tomekszafranski/Amiga500-SuperSelector/README.md

# Super Selector for Amiga 500

## Story

If you have real hardware Commodore Amiga 500 but don't have a wide collection of 3.5" floppies you probably would use Gotek drive for loading programs. But because most programs want to run from DF0, you need a device called _boot selector_ that allows changing drives assignment and boot from Gotek instead of internal drive. This is usually achieved using small switch mounted somewhere in the case or switchless by pressing Ctrl-Amiga-Amiga key combination for longer time. Great! Next, you may also want to have Kickstart ROM selector that allows having two or more versions of Kickstart e.g. Kickstart 3.1 (or later) for its features and older Kickstart 1.3 for compatibility. Again, this can be done by a switch mounted somewhere is the case or switchless by pressing Ctrl-Amiga-Amiga keys for longer time. The problem is when you want to use both devices and both switchless versions - they will probably mix up and there is no simple way to fix it as there is usially no possibility to reprogram/integrate them.

## How it works

This Super Selector allows to change two setting using one device. This is how it works:
* If you press Ctrl-Amiga-Amiga briefly or press and release it in less than 3 seconds, simple reset is executed. 
* If you keep Ctrl-Amiga-Amiga combination pressed beyond 3 seconds you will hear short tick - now you are in boot selector mode. If you release keys now, you will toggle boot device. After releasing keys you will hear one beep, meaning that internal floppy is selected or two beeps for external Gotek drive.
* If you keep Ctrl-Amiga-Amiga combination pressed beyond 6 seconds you will hear another short tick meaning you are in kickstart ROM selection mode. If you release keys now, you will toggle kickstarts. You will hear longer beep (for kickstart) and one or two beeps for first or second copy of Kickstart selected.
* If you keep keys pressed for more than 9 seconds you will hear another tick meaning switching is over and simple reset will be executed when keys are released.

Additionally, every time at boot you will hear one or two beeps meaning boot device is set to internal floppy or external Gotek device.

There is also a jumper on bottom side of PCB titled "external kickstart selector mode". In internal mode (jumper open) selector directly sets A18 line of Kickstart ROM to choose required Kickstart version. External mode (jumper closed) is meant to cooperate with external kickstart switcher you may already have which switches Kickstart after 3 second of holding Ctrl-Amiga-Amiga keys. You connect it as its Reset line.

Source code for ATtiny controller doing the switching is available so that you can customize it and reprogram even after installation.

## Installation

You have two PCBs. Installation is easy but think about how to put wires first.

1. Kickstart ROM:
* remove original Kickstart ROM and mount this PCB with 27C800 or 27C160 EPROM (socket facing north)
* PCB is designed so that you should be able to close the upper shield, to make it easier install low profile precision pins
* as minimum mount pin on A18. A19 can also be installed or set permanently to 0 or 1 (on bottom side) if not used (default)

kick

2. Selector itself (two versions available: smaller, mostly-SMD and THT-only):
* before you install selector in you Amiga it is needed to program ATtiny chip using programmer like USBasp. If you're building THT version you can program controller before putting in in a socket, for SMD version - use provided ICSP pins (insert programmer's pins and press them is enough to make contact
* remove Even CIA chip and mount it in a selector's socket (I recommend using precision sockets for original chips)
* install selector PCB in CIA socket on board with CIA chip facing north
* connect selector's pin KS to A18 on kickstart ROM (first PCB)
* connect selector's pin RST to pin 21 of Gary chip

smd
tht

smd
board

## Remarks

* Kickstart PCB has A18 and A19 address lines available so it is possible to choose from 4 version of kickstarts however this version of selector allows switching between only 2 versions (not enough pins on ATtiny)
* To prepare two-kickstarts EPROM you need 27C800 that can be programmed by popular TL-866Plus using 27C400/800/160 programmer adapter you can buy online. Rember to swap bytes before burning!

Have fun!

Tomek

> [!NOTE]
> **Disclaimer**: This is my project that I’ve built and it works for me. You can do it as well but remember, you’re responsible for your own doings
>
> **Licensed under**: CERN Open Hardware Licence Version 2 - Strongly Reciprocal. Read [CERN-OHL-S](https://ohwr.org/cern_ohl_s_v2.txt)
>
