tomekszafranski/Amiga500-SuperSelector/A500_SuperSelector_schematic.pdf

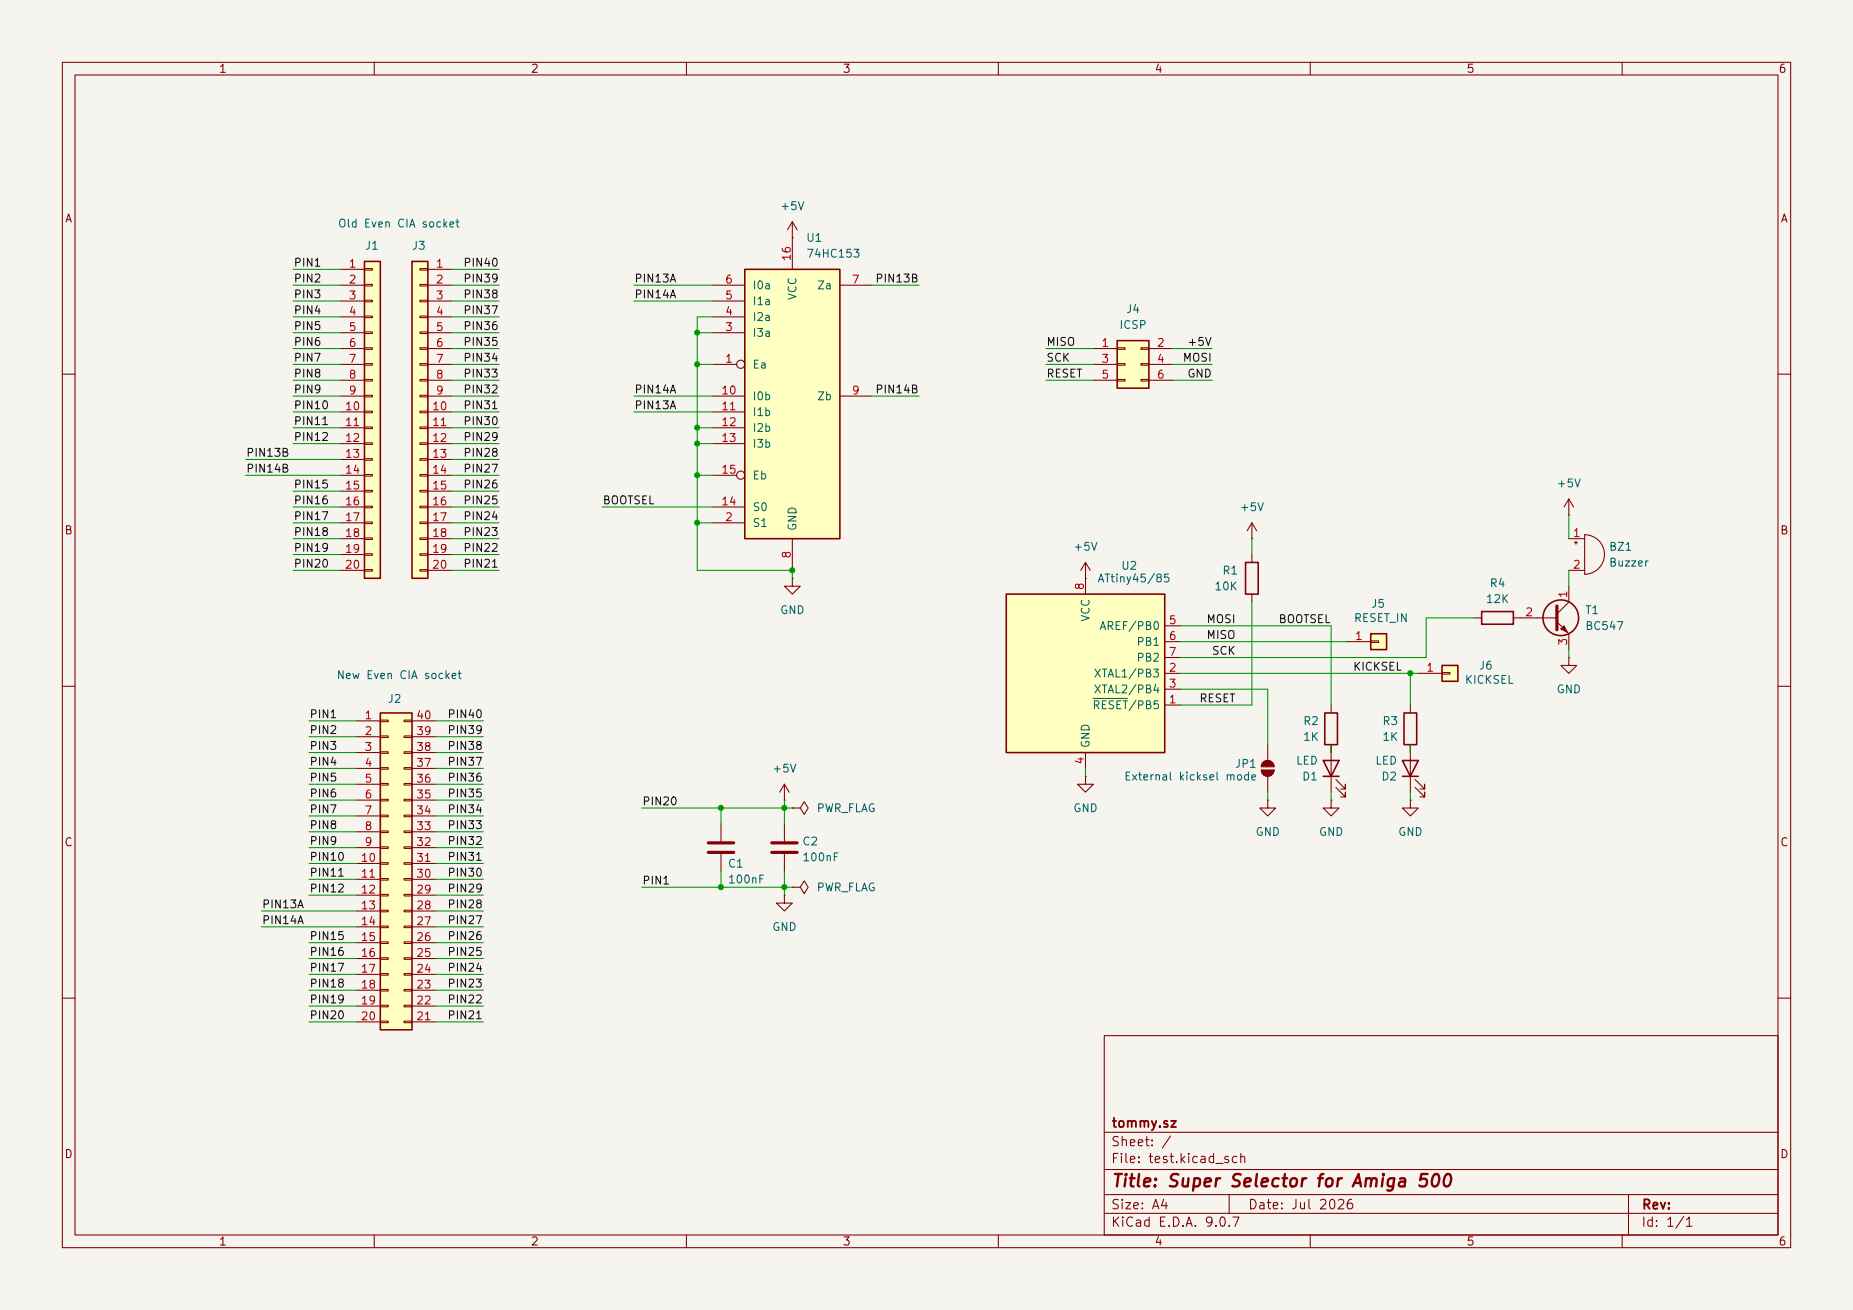
[picture p1: page 1]
